wagiminator/ATtiny13-NeoController/documentation/NeoController_pic5.jpg

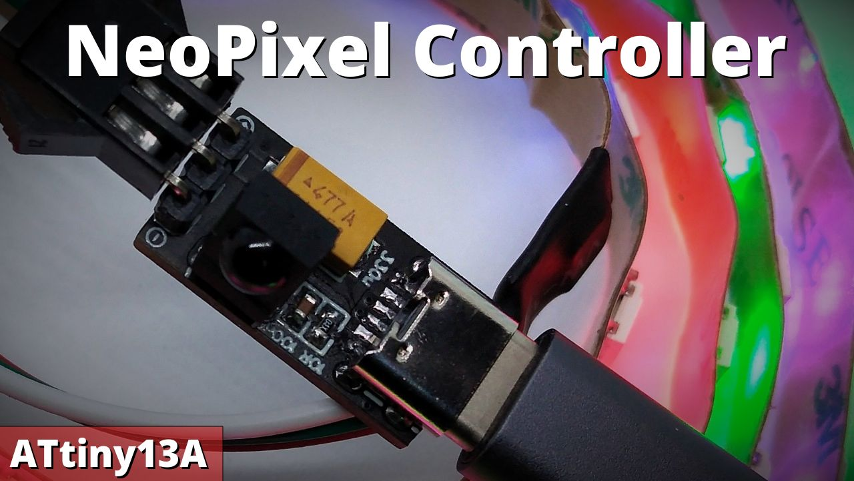
documentation/NeoController_pic5.jpg
