wagiminator/ATtiny13-NeoController/hardware/NeoController_BOM.tsv

ID | Name | Designator | Footprint | Quantity | Manufacturer Part | Manufacturer | Supplier | Supplier Part | Price
1 | 10u | C2 | 0603 | 1 | CL10A106MA8NRNC | SAMSUNG | LCSC | C96446 | 0.0359
2 | 330u | C3 | TANTALUM_CASE-D | 1 | TAJD337M010RNJ | AVX | LCSC | C105408 | 0.4076
3 | 100n | C1,C4 | 0603 | 2 | CC0603KRX7R9BB104 | YAGEO | LCSC | C14663 | 0.0034
4 | NeoPixel | H1 | 210S-3X1/2.54 | 1 | Header2.54mm 1*3P | BOOMELE | LCSC | C49257 | 0.0103
5 | ICSP | H2 | ICSP-PADS-SMALL | 1 | MTP125-1203S1 | MINTRON | LCSC | C358692 | 0.022
6 | 10k | R1 | 0603 | 1 | 0603WAF1002T5E | UniOhm | LCSC | C25804 | 0.001
7 | 10R | R2 | 0603 | 1 | 0603WAF100JT5E | UniOhm | LCSC | C22859 | 0.0014
8 | 330R | R3 | 0603 | 1 | 0603WAF3300T5E | UniOhm | LCSC | C23138 | 0.0012
9 | 5k1 | R4,R5 | 0603 | 2 | 0603WAF5101T5E | UniOhm | LCSC | C23186 | 0.0012
10 | ATtiny13A | U1 | SOP-8_150MIL | 1 | ATTINY13A-SSU | MICROCHIP | LCSC | C14075 | 0.7416
11 | TSOP4838 | U2 | TSOP18XX | 1 | TSOP4838 | VISHAY | LCSC | C124647 | 0.575
12 | USB-TYPE-C-6PIN | USB | USB-C-SMD-6P | 1 | TYPE-C-31-M-17 | Korean Hroparts Elec | LCSC | C283540 | 0.2435
