wagiminator/ATtiny13-NeoController/hardware/NeoController_schematic.pdf

# VCC PB⁵

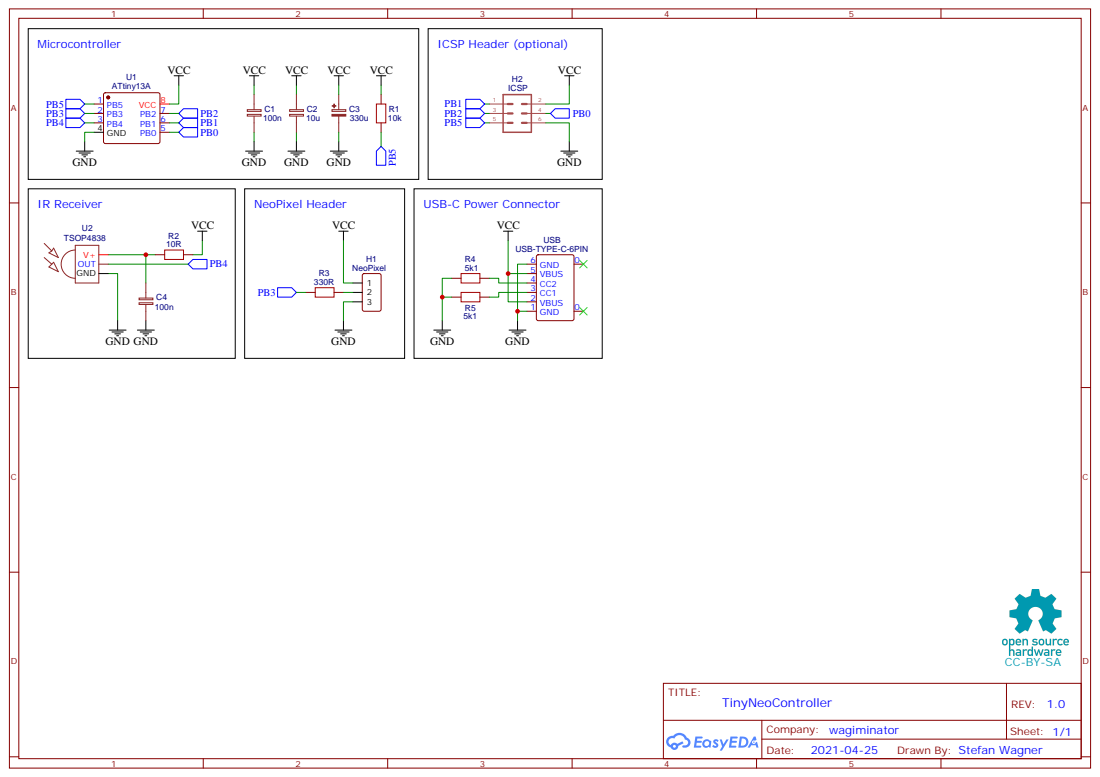
[picture p10: page 1]

Drawn By: Stefan Wagner
